pseudorandomnumber/laser-endoscope-mount/(commit log)

2026-10-23 Parametric endoscope mount for diode lasers
    [endoscope_mount.scad]
2026-10-23 Open scope bore past the collar, cam_drop from mount underside, restore measured presets
    [endoscope_mount.scad]
2026-10-23 Separate front and back corner radii, Falcon mod_d back to 47.1
    [endoscope_mount.scad]
2026-10-24 changed the default camera angle to 0
    [endoscope_mount.scad]
